Nabla33/Room_Occupancy_Indicating_Network/Documentation/Report/acknowledgement.tex

\newpage
\thispagestyle{empty}
\vspace*{3in}
\begin{normalsize}
	
\centerline{\textbf{Acknowledgement}}
\vspace{2cm}
\end{normalsize}

\par We would like to take this opportunity to thank Aashish Nehete for his immense help in creating and designing the web-based GUI for this project. We are also grateful to Prof. Kaiser Katchi for his help in 3D printing the project enclosure. We also thank our project guide and mentor, Prof. Priya Deshpande for her support and insights.
Special thanks to our institute, Sardar Patel Institute of Technology, for providing us with 3D printing services and a platform for us to showcase our project.

\vspace{2cm}

\hspace*{4in}  Chirag Shah

\hspace*{4in}  Srijal Poojari
