Nabla33/Room_Occupancy_Indicating_Network/Documentation/Report/bibliography.tex

\begin{thebibliography}{}
	
\bibitem{sparkfun}
~Sparkfun.com, `nRF24L01+ Transceiver Hookup Guide,' [Online].
Available:https://learn.sparkfun.com/tutorials/nrf24l01-transceiver-hookup-guide 
[Accessed: 10-Feb-2018]

\bibitem{geekstips}
~geekstips.com, `Internet of Things Project, Communication between ESP8266 modules,' [Online]. Available: https://www.geekstips.com/two-esp8266-communication-talk-each-other/ [Accessed: 18-Feb-2018] 

\bibitem{grabcad}
~GrabCAD, `Free cloud-based collaboration solutionto view and share CAD files,' [Online].
Available:https://grabcad.com/ [Accessed: 20-Mar-2018]

\bibitem{pcbway}
~PCBWay `PCB Manufacturing service'  [Online].
Available:https://pcbway.com/ [Accessed: 12-Mar-2018]

\bibitem{occupeye}
~Occupeye `OccupEye workspace utilisation sensors'  [Online].
Available:https://occupeye.com/ [Accessed: 11-Feb-2018]

\bibitem{workscape}
~Workscape `Workscape smart sensors'  [Online].
Available:https://workscape.io/ [Accessed: 11-Feb-2018]

\bibitem{github}
~ROIS on Github, `Room Occupancy Indicating Network,'  [Online].
Available:https://github.com/Nabla33/Room\_Occupancy\_Indicating\_Network [Accessed: 18-May-2018]

\end{thebibliography}
