Nabla33/Room_Occupancy_Indicating_Network/Documentation/Report/requirements.tex

\chapter{Hardware and Software Requirements}

\section{Hardware Requirements}
\begin{itemize}
\item ATmega328p Microcontroller
\item nRF24L01 RF module w/ External Antenna
\item OLED Module (for debugging)
\item FTDI 232RL USB to Serial converter for programming and debugging
\item Low quiescent current voltage regulator
\item Other miscellaneous components
\end{itemize}

\section{Software Requirements}
\begin{itemize}
	\item Sloeber IDE or the Arduino IDE 
	\item RF24, RF24Network and RF24 Mesh libraries by TMRh20
	\item Python 2.7
	\item Flask, SocketIO, Pyserial packages for Python
	\item HTML, CSS and Javascript for Web-GUI
\end{itemize}
