Nabla33/Room_Occupancy_Indicating_Network/Documentation/Report/certificate.tex

\newpage
\thispagestyle{empty}
\vspace*{0.2cm}
\vspace{1cm}
\begin{center}
 \large\textbf{CERTIFICATE }
\end{center}%%%%%%%%%%change d font to monotype corsiva
\vspace{2cm}
This is to certify that this is a bonafide record of the project presented by the students whose names are given below during Semister VI in partial fulfilment of the requirements of the degree of Bachelor of Engineering in Electronics Engineering.

\begin{table}[h]
\centering
\begin{tabular}{lr}
UCID & Names of Students \\ \\ \hline
\\
2015110048 &  Chirag Shah \\
2015110037 &  Srijal Poojari \\ 
 \hline 
\end{tabular}
\end{table}

\vspace{2.5cm}
\textbf {External Examiner} \hspace{2.8in} \textbf{Internal Examiner}
\vspace{2cm}\\
\textbf {(signature)} \hspace{3.5in} \textbf{(signature)} \\
\vspace{1cm}\\
\textbf {Name:} \hspace{3in} \textbf{Name:}\\ 
\vspace{1cm}\\
\textbf {Date:} \hspace{3in} \textbf{Date:}\\ 
\vspace{2cm}

\begin{center}
\textbf{Seal of the Institute}\\
\end{center}
%\hspace{1.5in}
%\vspace{2cm}
%\textbf {Dr. Prachi Gharpure}\\
%PRINCIPAL\\
\vspace{2cm}
