Nabla33/Room_Occupancy_Indicating_Network/Documentation/Report/main.tex

\documentclass[12pt,oneside,a4paper,graphicx]{report}
\usepackage[latin1]{inputenc}
\usepackage{amsmath}
\usepackage{amsfonts}
\usepackage{amssymb}
\usepackage{fullpage}
\usepackage{graphicx}
\usepackage{float}
\usepackage{textcomp}
\usepackage{pdfpages}
\usepackage{caption}
\usepackage{hyperref} %packagr for hyperlinks
\pagenumbering{Roman}
%\floatstyle{boxed}
%\restylefloat{figure}
%\topmargin 18mm
\textwidth 6.5in
%\headheight -8pt
%\headsep -12pt
\textheight 9.5in
%\footheight 18mm 
%\footskip 18mm
\bibliographystyle{plain}

\hypersetup{
	colorlinks=true,
	linkcolor=black,
	filecolor=red,
	urlcolor= cyan,
}
\urlstyle{same}

\captionsetup[figure]{font=small}
\graphicspath{{images/}}

\newcommand*{\captionsource}[2]{%
  \caption[{#1}]{%
    #1%, %
    , Source: #2%
  }%
}

\begin{document}
\input{Title}
\input{Certificate}
\input{Abstract}
\input{Acknowledgement}
\pagenumbering{Roman}
%\pagenumbering{}
\tableofcontents
\pagebreak
%\listoffigures
\pagebreak
\pagenumbering{arabic}
\input{Introduction}
\input{Hypothesis}
\input{MarketSurvey}
\input{requirements}
\input{Implementation}
\input{Software}
\input{Results}
\input{NextSteps}
\input{Conclusion}
\input{Bibliography}
\end{document}
