Nabla33/Room_Occupancy_Indicating_Network/Documentation/Report/title.tex

\begin{titlepage}

\begin{center}

\textup{\small {\bf MINI PROJECT - II\\  $6 ^{th}$ Semester (CBGS) } \\ Project Report}\\[0.2in]

% Title
\Large \textbf {Low Cost Real-time Room Occupancy Indicating System}\\[0.5in]

       \small \emph{Submitted in partial fulfillment of\\
        the requirements of the term work for subject MINI PROJECT - II}
        \vspace{1in}

% Submitted by
\normalsize Submitted by \\
\begin{table}[h]
\centering
\begin{tabular}{lr}\hline \\
UCID & Names of Students \\ \\ \hline
\\
2015110048 &  Chirag Shah \\
2015110037 &  Srijal Poojari \\ 
 \hline 
\end{tabular}
\end{table}

\vspace{.1in}
Under the guidance of\\
{\textbf{Prof. Priya Deshpande}}\\[0.2in]

\vfill

% Bottom of the page
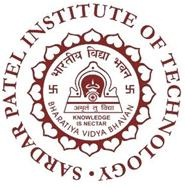
[picture p36: Documentation/Report/spit_logo.jpg]
\\[0.1in]

\textbf {Department of Electronics Engineering}\\
Bharatiya  Vidya Bhavan's\\
Sardar Patel Institute of Technology\\
Munshi Nagar, Andheri(W), Mumbai-400058\\
University of Mumbai\\
Academic Year 2017 - 18\\

\end{center}

\end{titlepage}
