Nabla33/Room_Occupancy_Indicating_Network/Documentation/Paper/images/1__17_.jpg

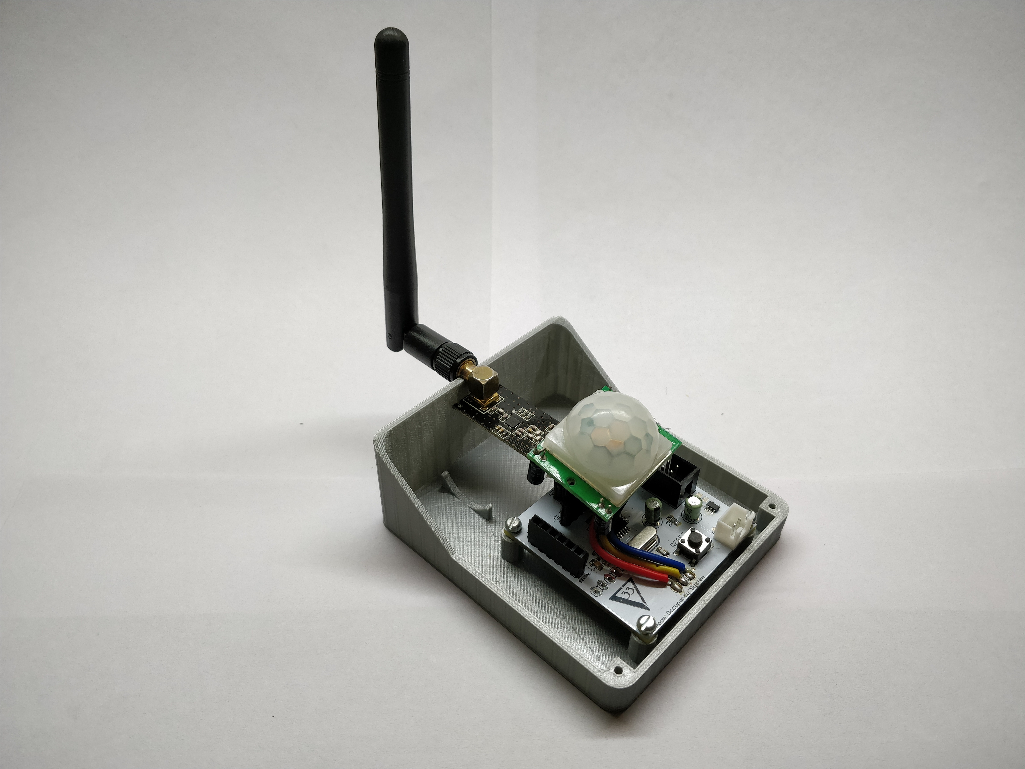
Documentation/Paper/images/1__17_.jpg
