Nabla33/Room_Occupancy_Indicating_Network/Documentation/Paper/images/single_breadboard.jpg

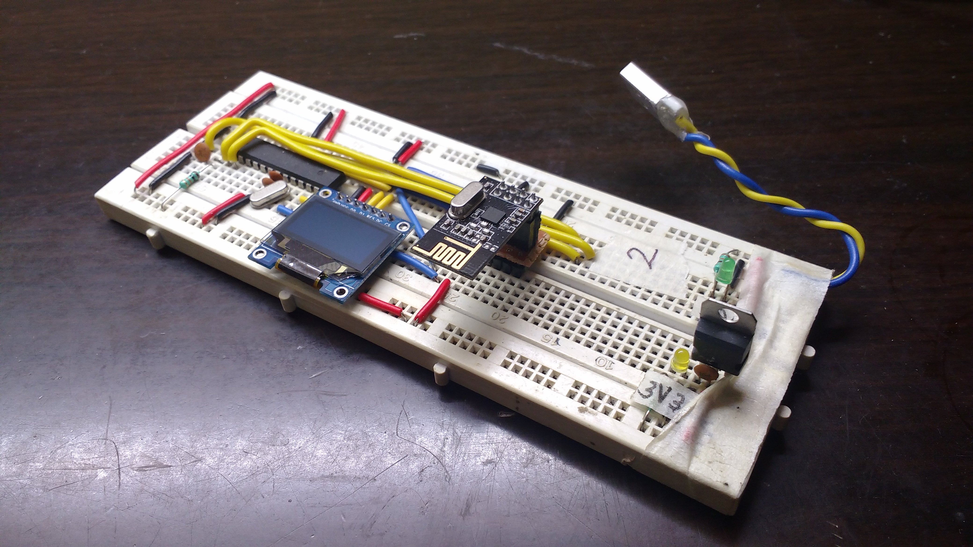
Documentation/Paper/images/single_breadboard.jpg
