Nabla33/Room_Occupancy_Indicating_Network/Documentation/Paper/images/Website3.PNG

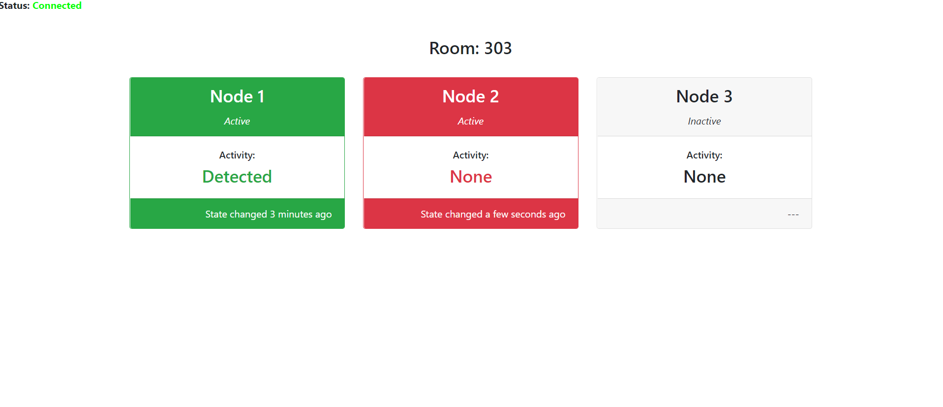
Documentation/Paper/images/Website3.PNG
