Nabla33/Room_Occupancy_Indicating_Network/3D files/node_top.stl

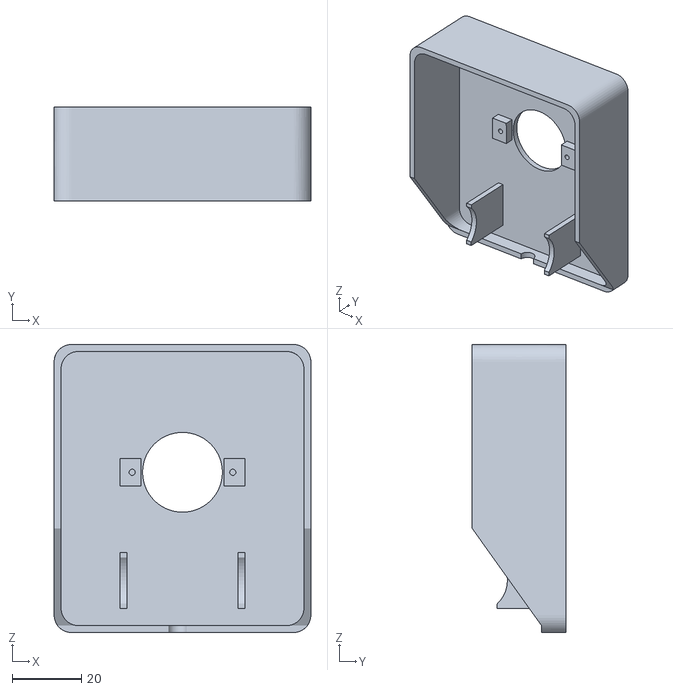
[picture p40: CAD file, 2018-04-12]
3D files/node_top.stl
74.0 x 27.0 x 83.0
