Nabla33/Room_Occupancy_Indicating_Network/3D files/node_base.stl

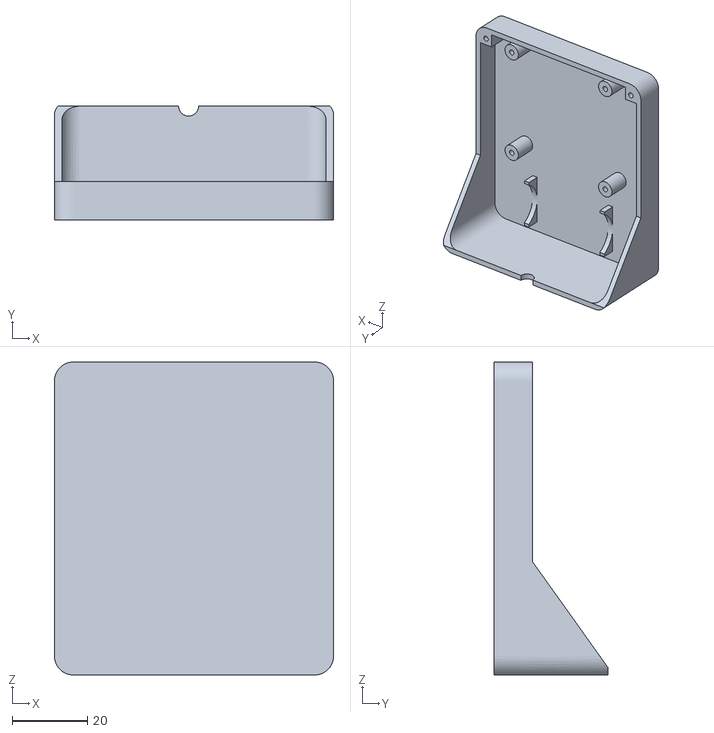
[picture p41: CAD file, 2018-04-12]
3D files/node_base.stl
74.0 x 30.2 x 83.0
