Nabla33/Room_Occupancy_Indicating_Network/PCB/PCB Design.brd

## EAGLE design PCB/PCB Design.brd (2018-04-19)

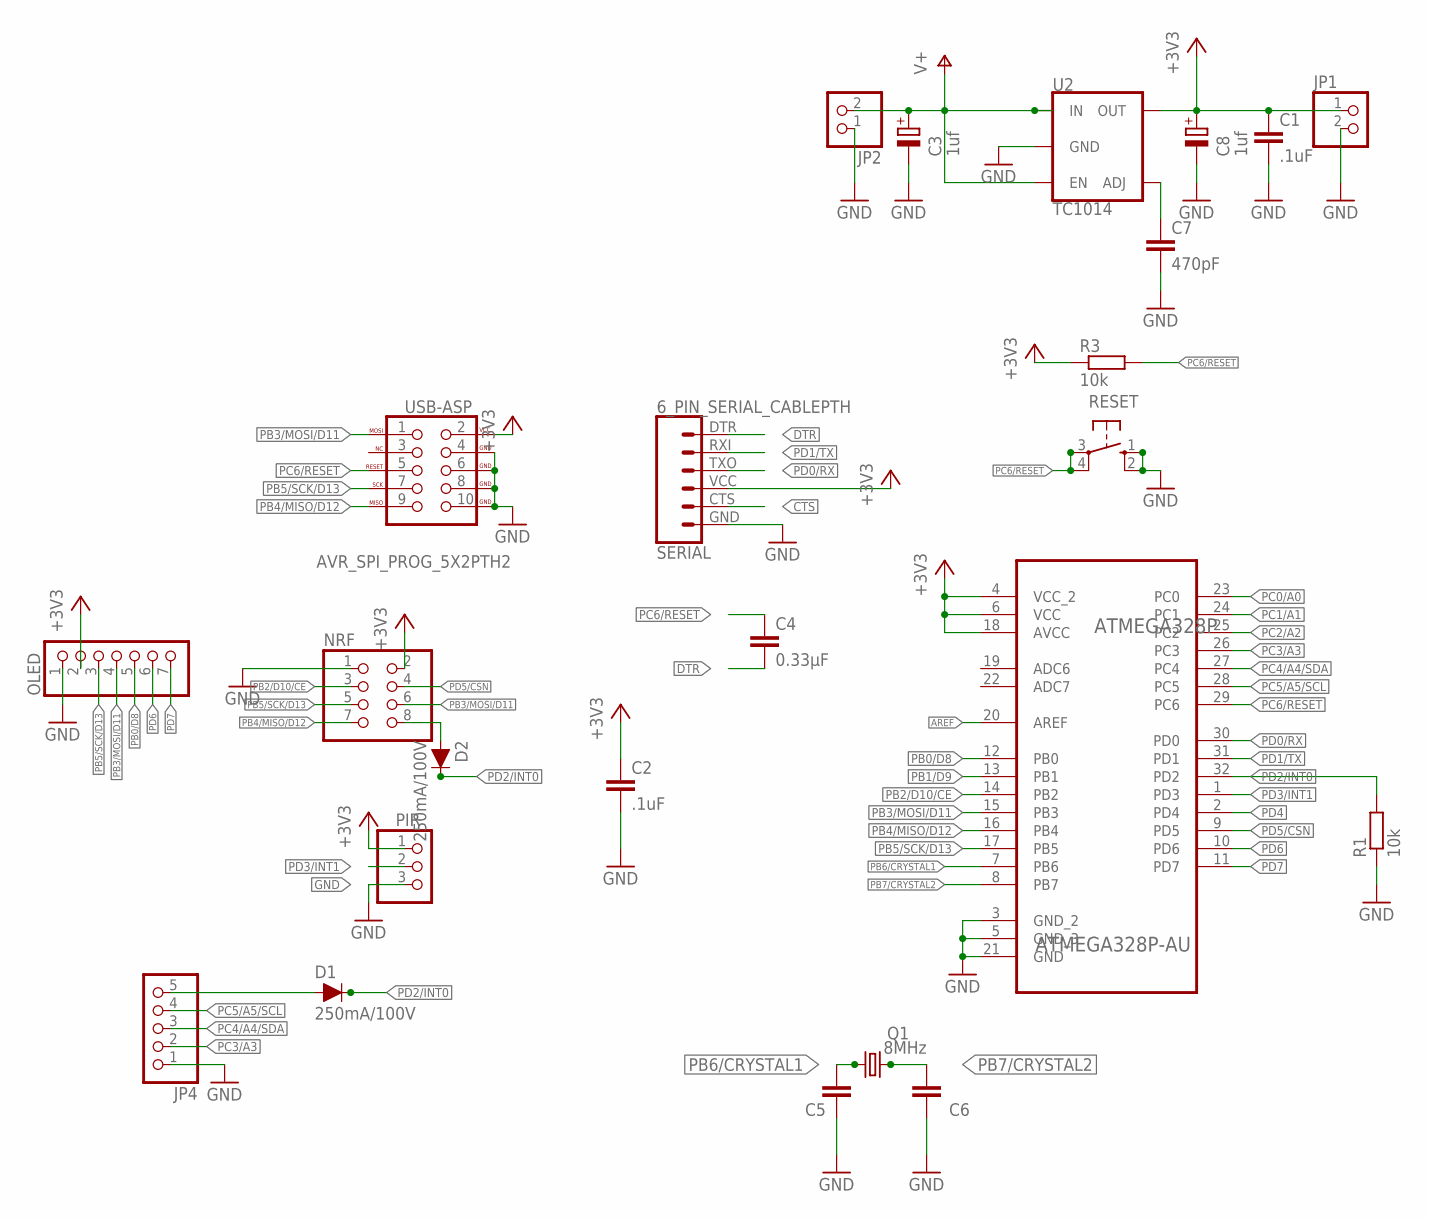
[picture p46: schematic PCB Design.sch]

Parts:
ATMEGA328P: ATMEGA328P-AU; QFP80P900X900X120-32N
C1, C2: .1uF; C0805K
C3, C8: 1uf; E2,5-5
C4: 0.33µF; C0805K
C5, C6: 22pF; C0805K
C7: 470pF; C0805K
D1, D2: 250mA/100V; SOD-323; MPN BNS33-11ZG-3M
JP1, JP2: PINHD-1X2; 1X02
JP4: PINHD-1X5; 1X05
NRF: PINHD-2X4; 2X04
OLED: PINHD-1X7; 1X07
PIR: PINHD-1X3; 1X03
Q1: 8MHz; HC49U70
R1, R3: 10k; M0805
RESET: 10-XX; B3F-10XX
SERIAL: 6_PIN_SERIAL_CABLEPTH; FTDI_BASIC
U2: TC1014; SOT23-5
USB-ASP: AVR_SPI_PROG_5X2PTH2; 2X5-SHROUDED

Connections:
8: D2.A, NRF.8
+3V3: ATMEGA328P.4 (VCC_2), ATMEGA328P.6 (VCC), ATMEGA328P.18 (AVCC), C1.1, C2.1, C8.+, JP1.1, NRF.2, OLED.2, PIR.1, R3.1, SERIAL.VCC (4), U2.5 (OUT), USB-ASP.2 (VCC)
AREF: ATMEGA328P.20 (AREF)
BYPASS: C7.1, U2.4 (ADJ)
CTS: SERIAL.CTS (5)
DTR: C4.2, SERIAL.DTR (1)
GND: ATMEGA328P.3 (GND_2), ATMEGA328P.5 (GND_3), ATMEGA328P.21 (GND), C1.2, C2.2, C3.-, C5.1, C6.1, C7.2, C8.-, JP1.2, JP2.1, JP4.1, NRF.1, OLED.1, PIR.3, R1.1, RESET.1 (S), RESET.2 (S1), SERIAL.GND (6), U2.2 (GND), USB-ASP.4 (GND), USB-ASP.6 (GND), USB-ASP.8 (GND), USB-ASP.10 (GND)
unnamed: D1.A, JP4.5
PB0/D8: ATMEGA328P.12 (PB0), OLED.5
PB1/D9: ATMEGA328P.13 (PB1)
PB2/D10/CE: ATMEGA328P.14 (PB2), NRF.3
PB3/MOSI/D11: ATMEGA328P.15 (PB3), NRF.6, OLED.4, USB-ASP.1 (MOSI)
PB4/MISO/D12: ATMEGA328P.16 (PB4), NRF.7, USB-ASP.9 (MISO)
PB5/SCK/D13: ATMEGA328P.17 (PB5), NRF.5, OLED.3, USB-ASP.7 (SCK)
PB6/CRYSTAL1: ATMEGA328P.7 (PB6), C5.2, Q1.1
PB7/CRYSTAL2: ATMEGA328P.8 (PB7), C6.2, Q1.2
PC0/A0: ATMEGA328P.23 (PC0)
PC1/A1: ATMEGA328P.24 (PC1)
PC2/A2: ATMEGA328P.25 (PC2)
PC3/A3: ATMEGA328P.26 (PC3), JP4.2
PC4/A4/SDA: ATMEGA328P.27 (PC4), JP4.3
PC5/A5/SCL: ATMEGA328P.28 (PC5), JP4.4
PC6/RESET: ATMEGA328P.29 (PC6), C4.1, R3.2, RESET.3, RESET.4 (P1), USB-ASP.5 (RESET)
PD0/RX: ATMEGA328P.30 (PD0), SERIAL.TXO (3)
PD1/TX: ATMEGA328P.31 (PD1), SERIAL.RXI (2)
PD2/INT0: ATMEGA328P.32 (PD2), D1.C, D2.C, R1.2
PD3/INT1: ATMEGA328P.1 (PD3), PIR.2
PD4: ATMEGA328P.2 (PD4)
PD5/CSN: ATMEGA328P.9 (PD5), NRF.4
PD6: ATMEGA328P.10 (PD6), OLED.6
PD7: ATMEGA328P.11 (PD7), OLED.7
V+: C3.+, JP2.2, U2.1 (IN), U2.3 (EN)

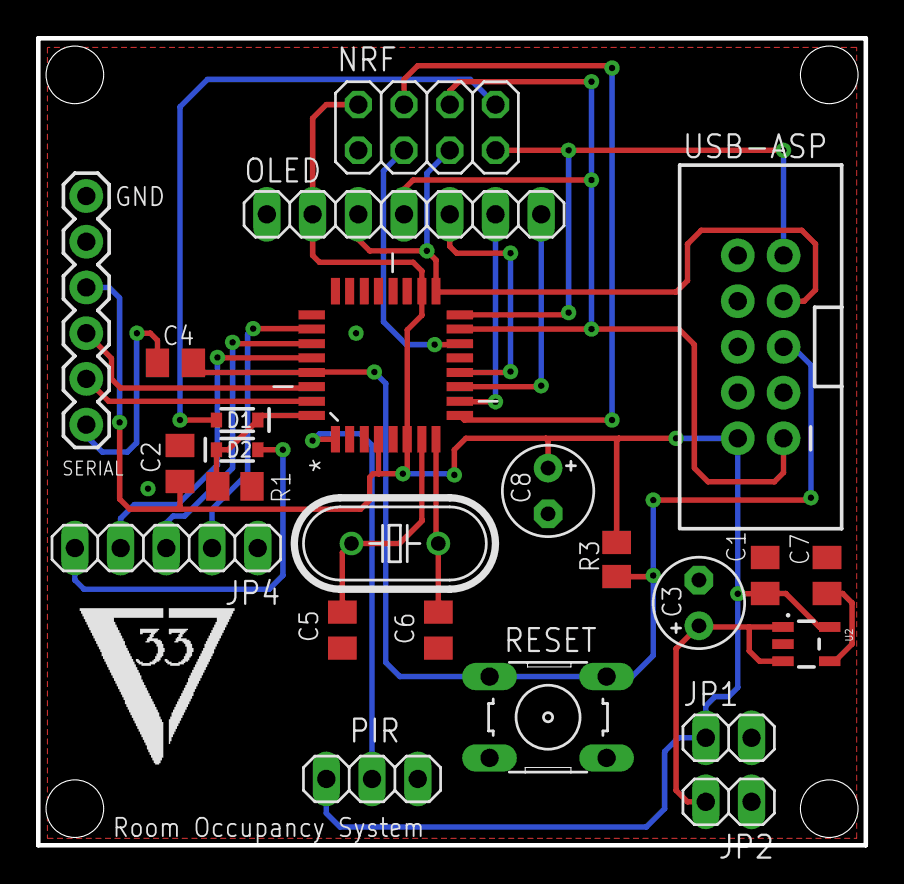
[picture p47: board PCB Design.brd from above]

Board: 2 copper layers, 46.0 x 44.8 mm, 24 parts (0 on the bottom side), 25 nets.
