Nabla33/Room_Occupancy_Indicating_Network/(commit log)

2018-03-31 Created PCB folder and added designs
    [PCB Design.brd, PCB Design.sch]
2018-03-31 Rearragned the board
2018-04-01 Added diode and rtc
    [PCB Design.brd]
2018-04-02 Generated Gerbers
    [PCB Design.brd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]
2018-04-11 Updated Arduino code after HDD data loss
2018-04-12 GUI now works! Minor Ardunio Code fixes
    [Room_Occupancy_Node.ino, master_interface.py, sloeber.ino.cpp]
2018-04-12 Added 3D printing files
    [node_base.stl, node_top.stl]
2018-04-19 Added Documentation folder
    [PCB Design.brd, PCB Design.sch]
